Borealin/figure-bases/pop-up-parade/2b__a2/base.step

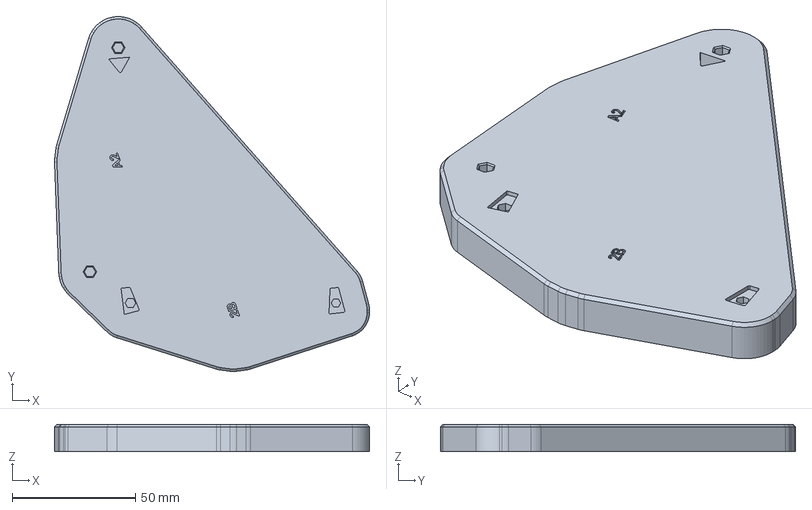
[picture p1: CAD file, 2026-10-08]
pop-up-parade/2b__a2/base.step
127.8 x 144.0 x 11.0 mm
