Borealin/figure-bases/pop-up-parade/byleth-male__byleth-female/base_a1mini.3mf

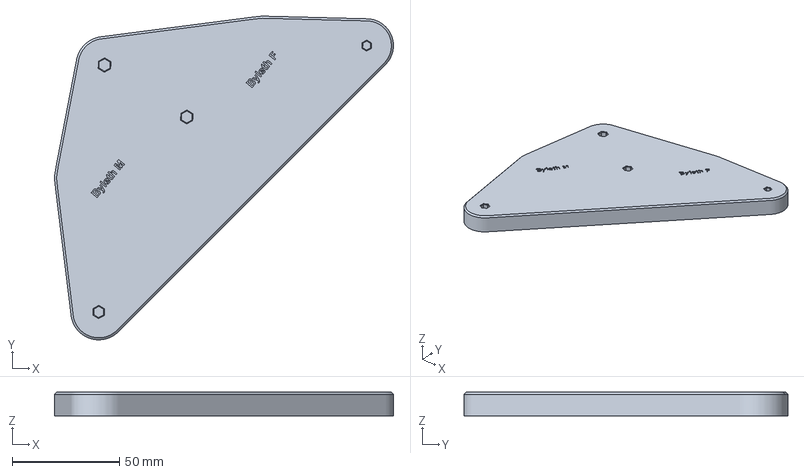
[picture p2: CAD file, 2026-10-08]
pop-up-parade/byleth-male__byleth-female/base_a1mini.3mf
158.1 x 151.0 x 11.0 mm
