Borealin/figure-bases/pop-up-parade/josuke-higashikata__rohan-kishibe/base_a1mini.3mf

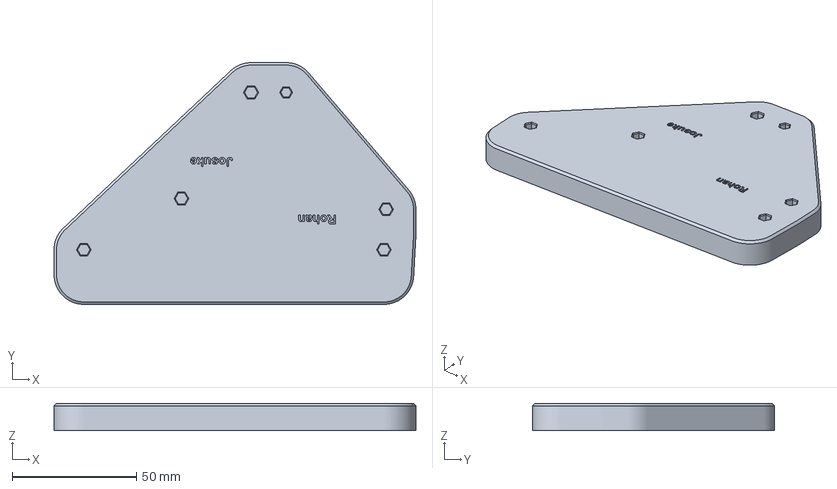
[picture p3: CAD file, 2026-10-08]
pop-up-parade/josuke-higashikata__rohan-kishibe/base_a1mini.3mf
145.8 x 97.4 x 11.0 mm
