Borealin/figure-bases/pop-up-parade/panty__stocking/base.step

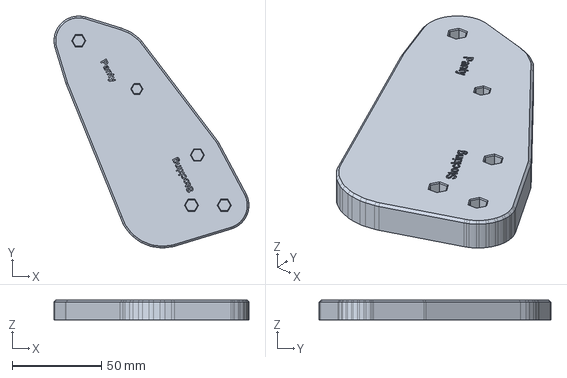
[picture p4: CAD file, 2026-10-08]
pop-up-parade/panty__stocking/base.step
109.5 x 130.2 x 11.0 mm
