Borealin/figure-bases/pop-up-parade/panty__stocking_repent/base.step

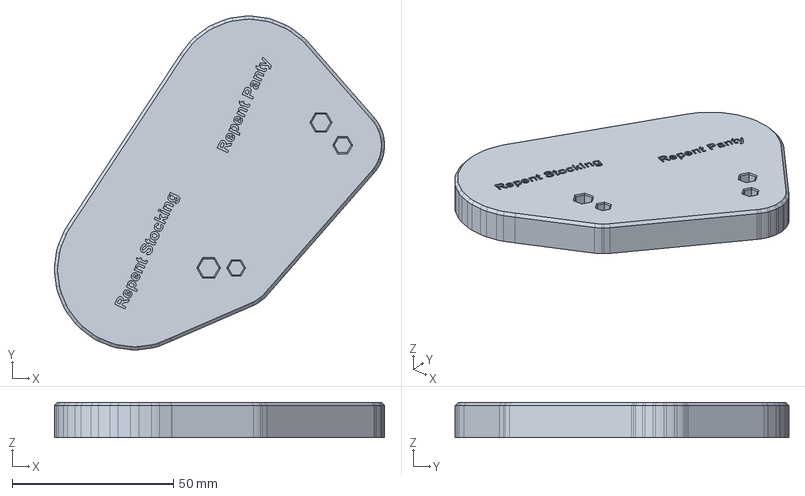
[picture p5: CAD file, 2026-10-08]
pop-up-parade/panty__stocking_repent/base.step
102.5 x 103.7 x 11.0 mm
