Borealin/figure-bases/pop-up-parade/ruby__ai__aqua__kana-arima/base_aqua-kana.step

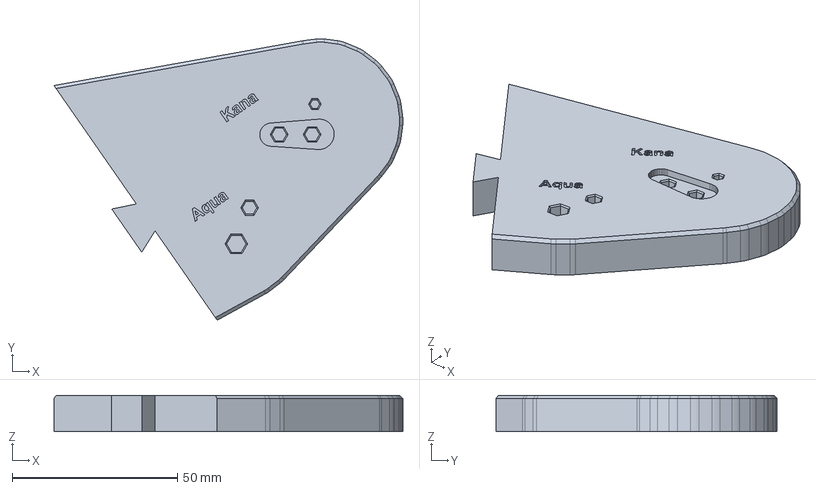
[picture p6: CAD file, 2026-10-08]
pop-up-parade/ruby__ai__aqua__kana-arima/base_aqua-kana.step
105.7 x 85.2 x 11.0 mm
