Borealin/figure-bases/pop-up-parade/wise__belle/base.step

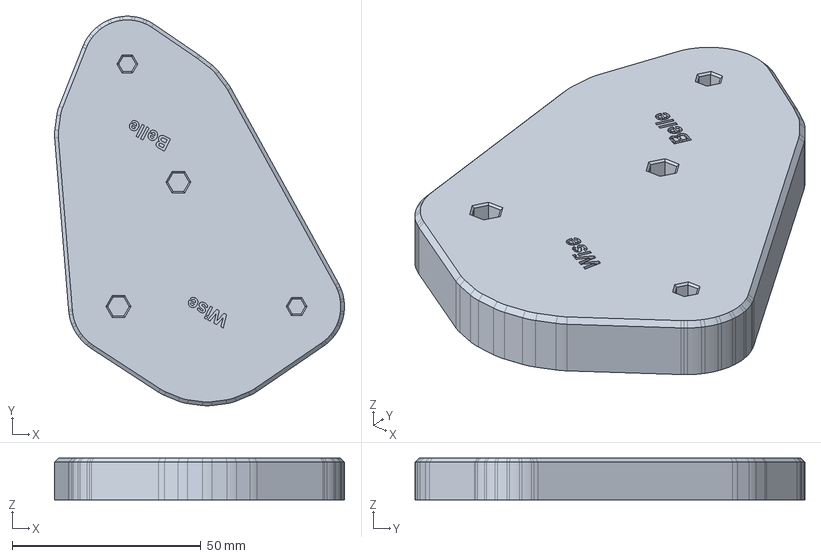
[picture p7: CAD file, 2026-10-08]
pop-up-parade/wise__belle/base.step
76.8 x 103.2 x 11.0 mm
