Borealin/figure-bases/pop-up-parade/2b__a2/base_a1mini.3mf

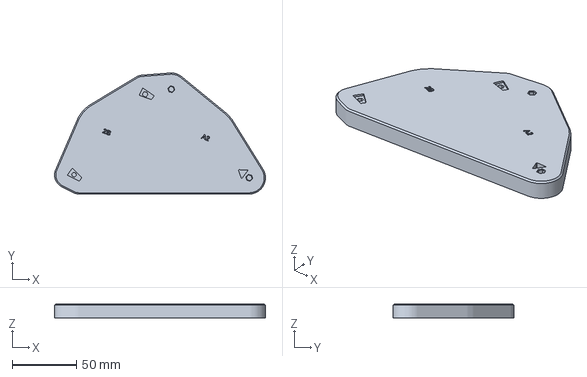
[picture p8: CAD file, 2026-10-08]
pop-up-parade/2b__a2/base_a1mini.3mf
164.0 x 94.1 x 11.0 mm
