Borealin/figure-bases/pop-up-parade/panty__stocking/base_a1mini.3mf

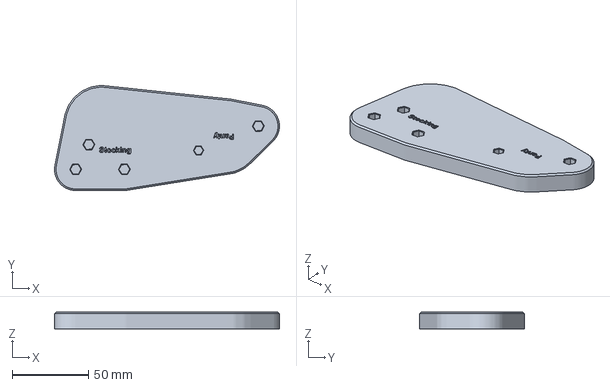
[picture p9: CAD file, 2026-10-08]
pop-up-parade/panty__stocking/base_a1mini.3mf
147.8 x 69.0 x 11.0 mm
