Borealin/figure-bases/pop-up-parade/panty__stocking_repent/base_a1mini.3mf

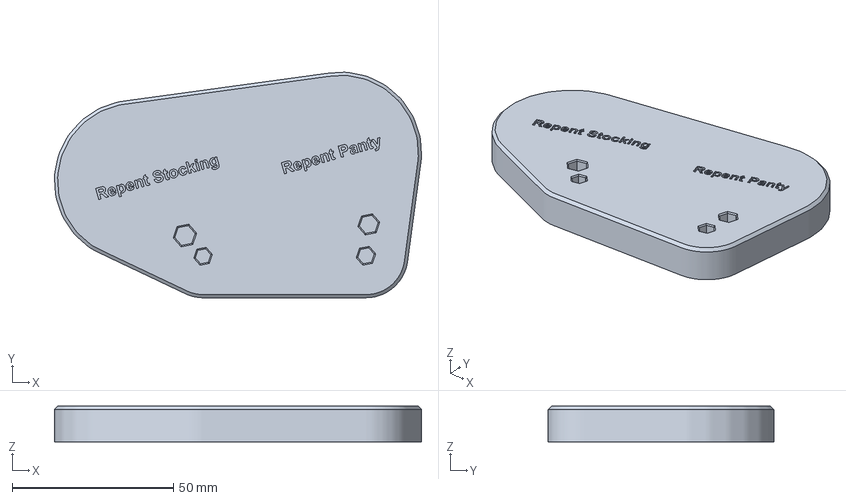
[picture p10: CAD file, 2026-10-08]
pop-up-parade/panty__stocking_repent/base_a1mini.3mf
113.7 x 69.9 x 11.0 mm
