Borealin/figure-bases/pop-up-parade/ruby__ai__aqua__kana-arima/base_ruby-ai.step

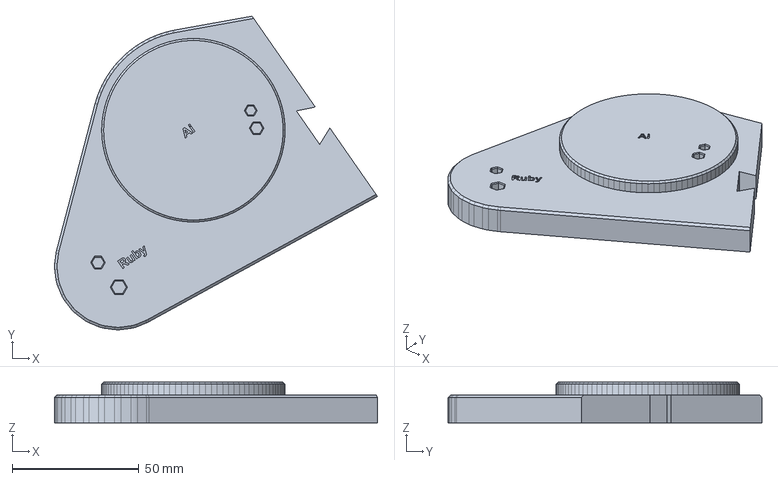
[picture p11: CAD file, 2026-10-08]
pop-up-parade/ruby__ai__aqua__kana-arima/base_ruby-ai.step
127.3 x 123.6 x 16.0 mm
