Borealin/figure-bases/pop-up-parade/wise__belle/base_a1mini.3mf

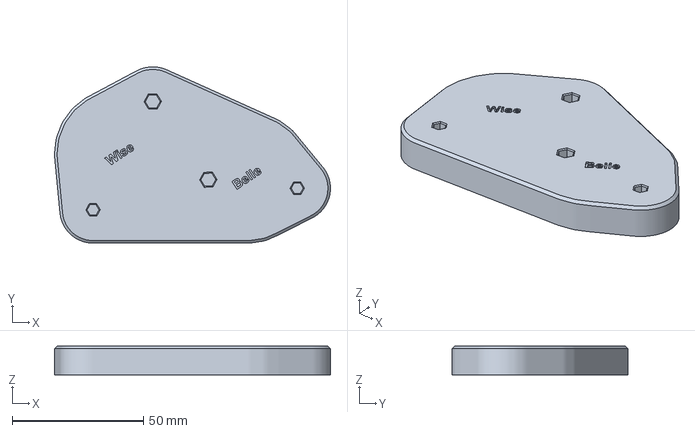
[picture p12: CAD file, 2026-10-08]
pop-up-parade/wise__belle/base_a1mini.3mf
105.3 x 67.3 x 11.0 mm
