Borealin/figure-bases/pop-up-parade/ruby__ai__aqua__kana-arima/base_a1mini.3mf

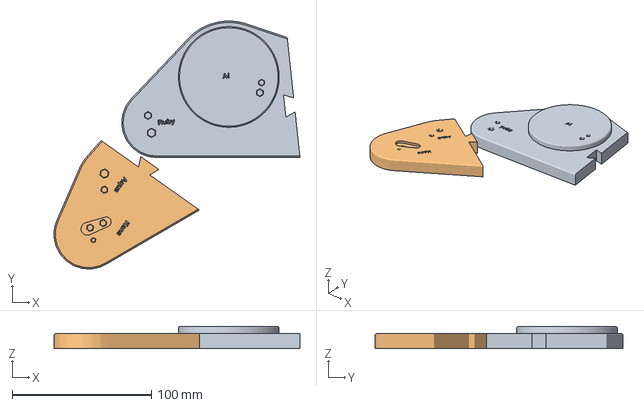
[picture p13: CAD file, 2026-10-08]
pop-up-parade/ruby__ai__aqua__kana-arima/base_a1mini.3mf
176.7 x 178.0 x 16.0 mm
model0.stl
model1.stl
