Borealin/figure-bases/(list of files, cad)

Other CAD files:
pop-up-parade/byleth-male__byleth-female/base.step
pop-up-parade/josuke-higashikata__rohan-kishibe/base.step
