Borealin/figure-bases/(commit log)

2026-10-01 Add POP UP PARADE Josuke Higashikata x Rohan Kishibe combined base
    Combined 3D-printed base for POP UP PARADE 東方仗助 and 岸辺露伴
    (JoJo's Bizarre Adventure: Diamond is Unbreakable), replacing the two
    original hexagonal bases with one 146 x 97 x 11 mm plate.
    - CadQuery script with measured peg / hole data and the solved layout
    - final base (STL/STEP/sliced 3MF for A1 mini), test pads, tolerance strip
    - tools: HEIC to JPG, Bambu preset flattening + CLI slicing, preview render
    [base.step, base.stl, base_a1mini.3mf, test_base_thin.stl, test_pads.stl, test_pads_a1mini.3mf, tolerance_strip.stl, tolerance_strip_a1mini.3mf]
2026-10-03 Add POP UP PARADE 2B x A2 combined base
    Combined 3D-printed base for POP UP PARADE 2B (YoRHa No.2 Type B) and
    A2 (YoRHa Type A No.2) from NieR:Automata Ver1.1a, replacing the round
    and hexagonal original bases with one 128 x 144 x 11 mm plate.
    - per-hole clearances, 2B heel recesses and A2 triangular heel recess,
    tuned over two pad iterations and one thin test base
    - layout solved from six measured pad distances (mirror confirmed)
    - final base (STL/STEP/sliced 3MF) plus the printed trial versions
    - root README: list entry and lessons learned (caliper battery, heel
    recess depth, mirror ambiguity with two-hole figures)
    [base.step, base.stl, base_a1mini.3mf, test_base_thin.stl, test_base_thin_a1mini.3mf, test_base_thin_v1.stl, test_base_thin_v1_a1mini.3mf, trial_v1.stl]
2026-10-05 Add four more combined bases, shared basekit, name labels on all bases
    New sets:
    - POP UP PARADE Panty & Stocking Set (back-to-back, printed)
    - POP UP PARADE Panty & Stocking Set: Repent Ver. L Size (trial)
    - POP UP PARADE Byleth (Male) x Byleth (Female) (trial)
    - POP UP PARADE SP Wise x Belle (trial)
    Tools:
    - tools/basekit.py: two-pair layout solver with "never closer than
    measured" push-out, front/left-to-right mirror check, outline, base
    builder, automatic label placement (engraved / raised)
    - tools/base_preview.py: top view on the A1 mini bed + iso preview
    - slice_a1mini.ps1 accepts several STLs to arrange on one plate
    - plates/: batch print plates (trial plates and final bases)
    Al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
    [base.step, base.stl, base_a1mini.3mf, base_v1.step, base_v1.stl, base_v1_a1mini.3mf, base_v2.step, base_v2.stl]
2026-10-06 Finalize hole sizes with fit samples; Repent / Byleth / Wise x Belle printed
    - tools/fit_samples.py: hat-shaped cylinder samples, tolerance strip,
    96-104% first-wave grades and +-2% nudges from the tried hole
    - figure_base.py --samples for the three sets; hole sizes now set as a
    percentage of the pad hole (FIT_PCT) instead of full mm steps
    - Wise x Belle: printed base kept as base_v1, W2 widened 3.95 -> 3.97
    - README: new sample workflow, fit experience, print status
    [base.step, base.stl, base_a1mini.3mf, base_v1.step, base_v1.stl, base_v1_a1mini.3mf, fit_samples_v1.stl, plate_byleth-base_a1mini.3mf]
2026-10-08 Add Oshi no Ko four-figure base (Ruby / Ai / Aqua / Kana)
    - Four figures on a two-piece base joined by a dovetail (too big for the
    A1 mini in one piece); Ai stands on a 5 mm round stage
    - basekit: multi-group layout solve (multi-start least squares, pick the
    mirror by figure facing, push apart along the chain), shoe recesses,
    raised platforms, dovetail split with per-side clearance
    - fit_samples: narrow gauge bars, shared bars for pegs of similar size
    - Printed base kept as base_*_v1; current base has Aqua's holes 1% smaller
    (pegs are not quite parallel and pop out when loose)
    - README: workflow for 3+ figures, dovetail and peg-splay notes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
    [base_a1mini.3mf, base_aqua-kana.step, base_aqua-kana.stl, base_aqua-kana_a1mini.3mf, base_aqua-kana_v1.step, base_aqua-kana_v1.stl, base_ruby-ai.step, base_ruby-ai.stl]
2026-10-08 Restructure: one folder per set with final base.py / STEP / 3mf / README
    - Each set now holds only README.md, base.py (final script), base.step,
    base_a1mini.3mf and images/ (preview + hole labels)
    - base.py stripped to the final base; verified every set regenerates the
    same STEP (volume, area, bbox) as before
    - Process files (pads, fit samples, trial bases, printed old versions,
    cross-set plates) removed from the tree; they live in tag
    archive/process-2026-10-08, and each README keeps a short process table
    - Official product links in every README; Oshi no Ko set moved to
    pop-up-parade/ruby__ai__aqua__kana-arima
    - tools/setkit.py: shared STEP export and --slice for base.py
    Co-Autho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
    [base.step, base.stl, base_a1mini.3mf, base_aqua-kana.step, base_aqua-kana.stl, base_aqua-kana_a1mini.3mf, base_aqua-kana_v1.step, base_aqua-kana_v1.stl]
